Alia5/PiCCANTE/hardware/PiCCANTE-OBD-Dongle/PCB/case/Bottom.stl

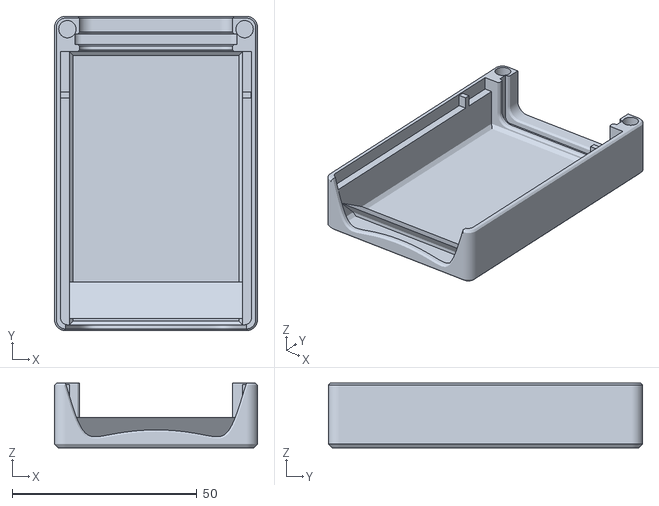
[picture p1: CAD file, 2025-05-24]
hardware/PiCCANTE-OBD-Dongle/PCB/case/Bottom.stl
55.0 x 85.2 x 17.5
