Alia5/PiCCANTE/hardware/PiCCANTE-OBD-Dongle/PCB/case/LID.stl

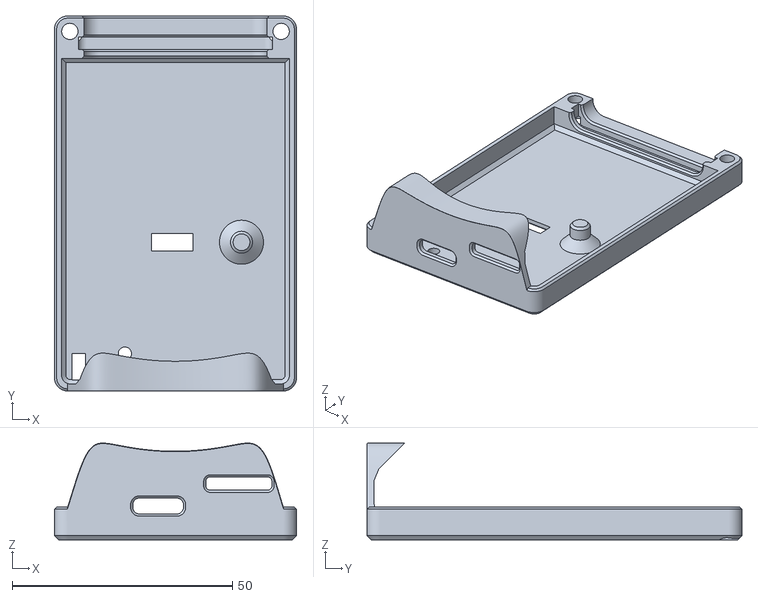
[picture p2: CAD file, 2025-05-24]
hardware/PiCCANTE-OBD-Dongle/PCB/case/LID.stl
55.0 x 85.2 x 22.0
