Alia5/PiCCANTE/hardware/PiCCANTE-OBD-Dongle/Perfboard/case/perfboard/PiCCANTE Case.step

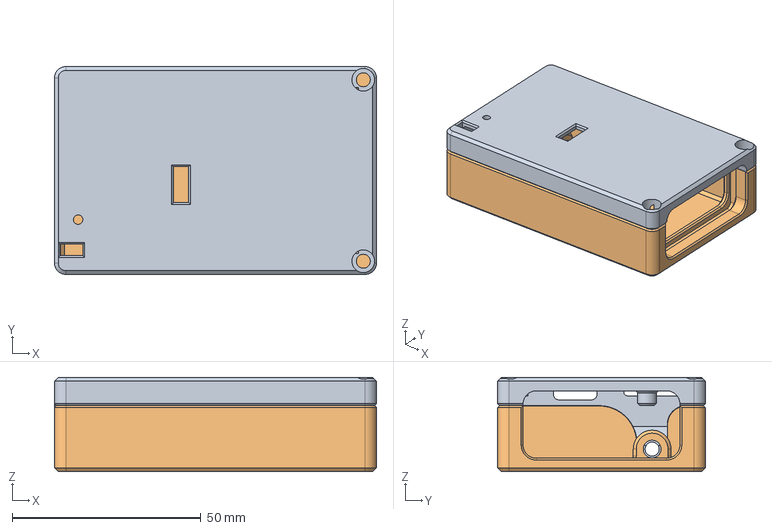
[picture p3: CAD file, 2025-05-03]
hardware/PiCCANTE-OBD-Dongle/Perfboard/case/perfboard/PiCCANTE Case.step
85.2 x 55.0 x 25.0 mm
