Alia5/PiCCANTE/hardware/PiCCANTE-OBD-Dongle/Perfboard/case/perfboard/Lid.stl

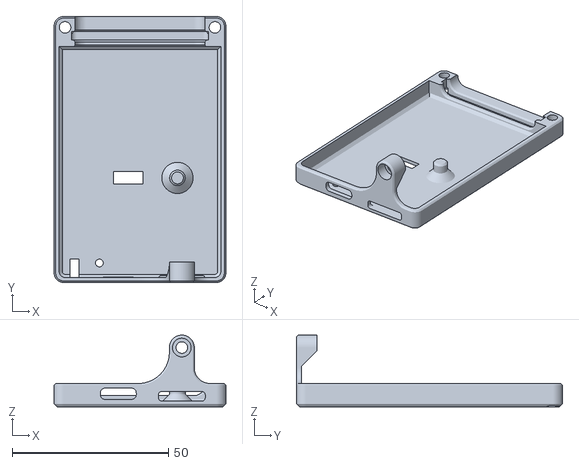
[picture p4: CAD file, 2025-05-03, an earlier design]
hardware/PiCCANTE-OBD-Dongle/Perfboard/case/perfboard/Lid.stl
55.0 x 85.2 x 23.0
