Alia5/PiCCANTE/(list of files, cad)

Other CAD files:
hardware/PiCCANTE-OBD-Dongle/Perfboard/case/perfboard/Bottom.stl
