Alia5/PiCCANTE/(threads)

Thread 2 (2025-04-13):

[FEATURE] Implement ELM327 emulator

Alia5, 2025-04-13:
## Description
Add ELM327 emulator functionality to PiCCANTE to increase compatibility with automotive diagnostic software.

## Requirements
- Support standard ELM327 AT commands
- Implement OBD-II PIDs for common vehicle data
- Allow passthrough to raw CAN commands
- Maintain compatibility with popular OBD-II apps

Alia5, 2025-05-01:
- Supports most basic ELM AT commands (except setting up CAN-bus / protocol scan, memory, filters)
- Compatible with Torque
  - Tested in (2021) Alfa Giulia

Thread 3 (2025-04-13):

[FEATURE] Add WiFi/Bluetooth support for Pico W models

Alia5, 2025-04-13:
## Description
Implement wireless connectivity for Pico W and Pico 2 W models to enable remote vehicle diagnostics and data streaming.

## Requirements
- WiFi Access Point mode for direct connections
- WiFi Client mode for connecting to existing networks
- Bluetooth connectivity for mobile devices
- Secure communication protocols

## Technical Considerations
- Security considerations
  - disable by default
  - requires USB connection to setup
  - no default credentials

Closed 2025-04-14.

Thread 4 (2025-04-13):

[FEATURE] Develop MITM mode for advanced analysis/vehicle tuning

Alia5, 2025-04-13:
## Description
Create a Man-In-The-Middle mode that allows intercepting, modifying, and retransmitting CAN messages for advanced vehicle analysis and tuning.

## Requirements
- Ability to intercept CAN messages between vehicle systems
- Rule-based filtering and modification of messages
- Message logging capabilities
- Optional transparent passthrough mode

## Technical Considerations
- Requires careful timing to avoid vehicle communication issues
- May need buffer management for high-throughput situations

Thread 5 (2025-04-13):

[FEATURE] Implement data logging to SD card

Alia5, 2025-04-13:
Add support for logging CAN bus data directly to SD card for offline analysis and long-term monitoring.

## Requirements
- SD card interface implementation
- Configurable logging formats (CSV, native binary, etc.)
- Timestamping of messages
- Filtering options to reduce storage requirements
- Integration with existing PiCCANTE commands

## Technical Considerations
- SD card interface connections and pin usage
- File system compatibility and reliability
- Performance optimization for continuous logging

Thread 6 (2025-04-13):

[FEATURE] Design 3D printable case for OBD-II dongles

Alia5, 2025-04-13:
## Description
Create 3D printable case designs for making PiCCANTE-based OBD-II dongles that can be easily manufactured by users.

## Requirements
- Compact enclosure for Pico + CAN transceivers
- OBD-II connector integration
- Access to USB port for firmware updates
- Multiple designs for different use cases (basic/advanced)

## Technical Considerations
- Design should be printable on consumer 3D printers
- Include mounting options for optional components (buck converter)

Closed 2025-05-03.

Thread 7 (2025-04-13):

[FEATURE] Design custom PCB for PiCCANTE

Alia5, 2025-04-13:
## Description
Design a custom PCB for PiCCANTE to replace perfboard solutions and simplify assembly.

## Requirements
- Mounting for Raspberry Pi Pico (any model)
- Dedicated interfaces for up to 3 CAN transceivers
- Power management circuitry for automotive use
- Optional OBD-II connector footprint
- Expansion headers for additional functionality

## Technical Considerations
- Should be manufacturable through standard PCB services
- Consider KiCad or similar open-source design software
- Include protection circuitry for automotive environments
- Design for both through-hole and SMD assembly options

Thread 10 (2025-04-14):

[FEATURE]  Web based configuration interface

Alia5, 2025-04-14:
Create a lightweight web interface to configure PiCCANTE through browsers.

### Requirements
- Device Configuration without CLI
- ~Optional CLI~
- Mobile-friendly interface
- ~Visual monitoring of CAN traffic~

### Implementation
- Simple HTTP server on Pico W
- Minimal Svelte SPA
- Store in LittleFS

GitFun4All, 2025-09-17:
This looks really nice (from local npx) but I can't get wifi to come up on a pico2_w.  The bin compiles but setting either a wifi ap mode (results in no ip) or sta advertised or when I try connect mode, it fails to join forever (wpa2 network)?

Closed 2025-04-22.

Thread 9 (2025-04-14):

[FEATURE] Bluetooth on Pico W / Pico 2 W models

Alia5, 2025-04-14:
## Description
Implement bluetooth connectivity for Pico W and Pico 2 W models to enable remote vehicle diagnostics and data streaming.

## Requirements
- Bluetooth connectivity for mobile devices

## Technical Considerations
- Security considerations
  - disable by default
  - requires USB connection to setup
  - no default credentials

Alia5, 2025-05-01:
Currently only implemented for ELM-Emulator

Closed 2025-05-01.

Thread 11 (2025-04-15):

[FEATURE]  Deep Sleep (dormant mode)

Alia5, 2025-04-15:
# Description

Enable deep-sleep mode after a period of CAN inactivity to save power.

# Requirements

- Configurable
- Default on
  - Sane default timeout (5 minutes or so)
- Should auto wake up upon receiving a CAN frame
   - Okay to fully reset the chip on a first draft after wakeup
   - Okay to loose CAN-frames after wakup until reset. (first draft)

Closed 2025-04-15.

Thread 12 (2025-04-15):

Properly handle unread USB-CDC ports

Alia5, 2025-04-15:
# Description.

Currently, there is an arguably "dirty" hack in place to prevent unread CDC-Ports from clogging the tasks.
See: https://github.com/Alia5/PiCCANTE/blob/main/src/outstream/usb_cdc_stream.cpp#L27-L45

A way to properly handle this case should be implemented

Closed 2025-05-01.

Thread 15 (2025-04-29):

[FEATURE]  Watchdog in case Firmware Crashes

Alia5, 2025-04-29:
Enable the Watchdog in case the firmware crashes.

Closed 2025-05-01.

Thread 17 (2025-05-01):

[FEATURE]  ELM327: Extend AT command support to add filters

Alia5, 2025-05-01:
Currently, the ELM327 Emulator doesn't have support for Filters. (`ATCRA`-command)

A fully compatible `ATCRA`-Filter command implementation should be added

Thread 21 (2025-05-02):

[FEATURE]  SD-Card support

Alia5, 2025-05-02:
Implement/add a basic SD-Card / FAT-FS driver

Alia5, 2025-05-02:
Added SD-Card lib from [here ](https://github.com/carlk3/FreeRTOS-FAT-CLI-for-RPi-Pico/tree/master) and added a very basic wrapper in `sd_card/*`

Should be enough to implement data-logging at a later date

Closed 2025-05-02.
