Alia5/PiCCANTE/hardware/PiCCANTE-OBD-Dongle/PCB/PiCCANTE-OBD-Dongle.kicad_pcb

## KiCad design hardware/PiCCANTE-OBD-Dongle/PCB/PiCCANTE-OBD-Dongle.kicad_pcb (2025-05-10)

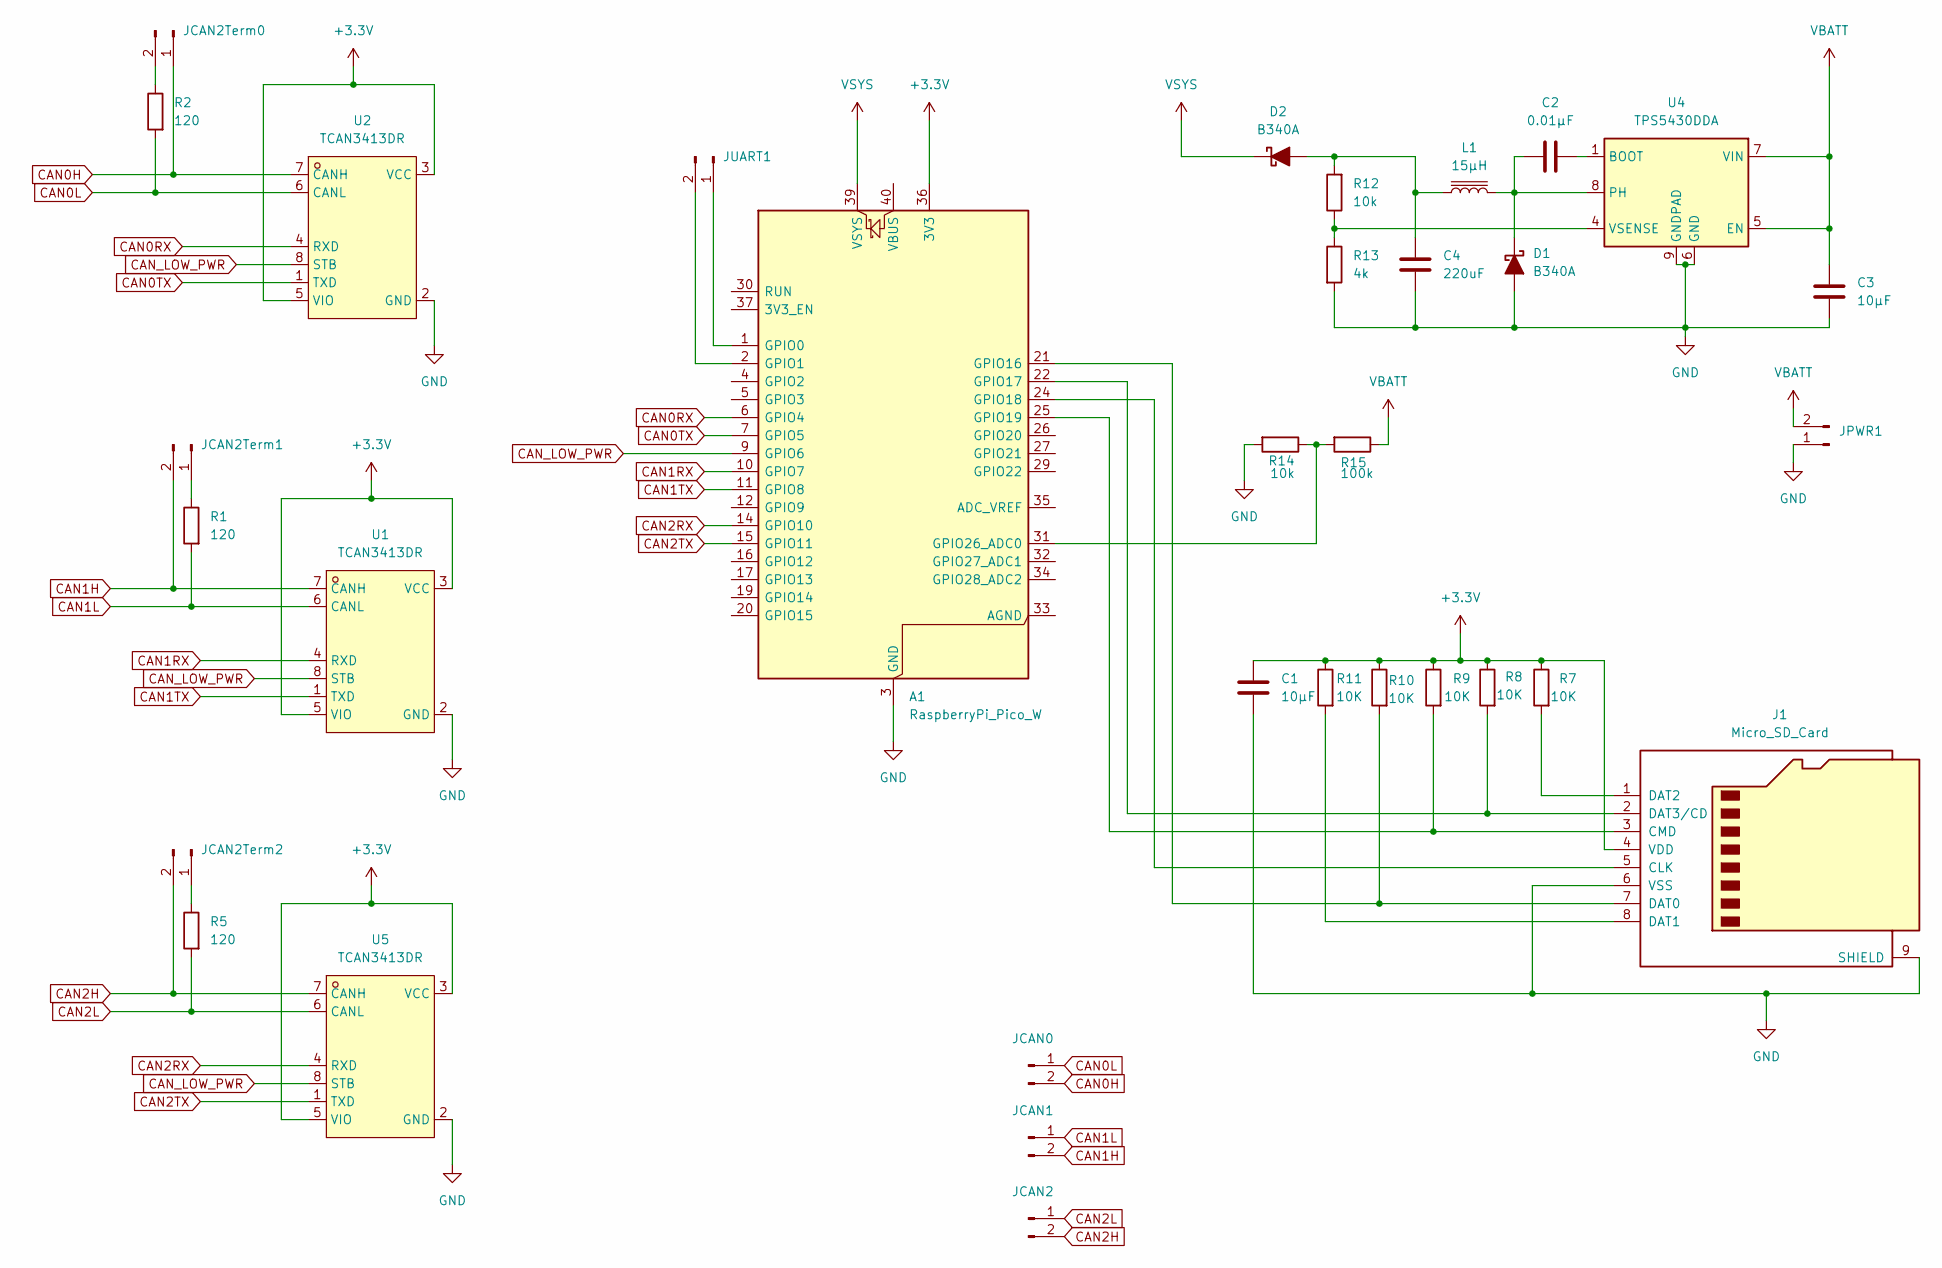
[picture p5: schematic PiCCANTE-OBD-Dongle.kicad_sch]

Parts:
A1: RaspberryPi_Pico_W; RaspberryPi_Pico_W_SMD_THT_COMBO_CUSTOM_KEEPOUT
C1: 10µF; C_0603_1608Metric
C2: 0.01µF; C_0603_1608Metric
C3: 10µF; C_1206_3216Metric
C4: 220uF; C_1206_3216Metric
D1, D2: B340A; SMA_L4.4-W2.6-LS5.0-RD
J1: Micro_SD_Card; TF-SMD_503398-1892
JCAN0, JCAN1, JCAN2, JCAN2Term0, JCAN2Term1, JCAN2Term2: PinHeader_1x02_P2.54mm_Vertical
JPWR1: PinHeader_1x02_P2.54mm_Horizontal
JUART1: PinHeader_1x02_P2.54mm_Vertical
L1: 15µH; IND-SMD_L4.0-W4.0
R1, R2, R5: 120; R_0603_1608Metric
R7, R8, R9, R10, R11: 10K; R_0603_1608Metric
R12, R14: 10k; R_0603_1608Metric
R13: 4k; R_0603_1608Metric
R15: 100k; R_0603_1608Metric
U1, U2, U5: TCAN3413DR; SOP-8_L4.9-W3.9-P1.27-LS6.0-BL-1; LCSC Part C22433320
U4: TPS5430DDA; TI_SO-PowerPAD-8_ThermalVias

Connections:
+3.3V: A1.36 (3V3), C1.1, J1.4 (VDD), R7.1, R8.1, R9.1, R10.1, R11.1, U1.3 (VCC), U1.5 (VIO), U2.3 (VCC), U2.5 (VIO), U5.3 (VCC), U5.5 (VIO)
CAN0H: JCAN0.2, JCAN2Term0.1, U2.7 (CANH)
CAN0L: JCAN0.1, R2.1, U2.6 (CANL)
CAN0RX: A1.6 (GPIO4), U2.4 (RXD)
CAN0TX: A1.7 (GPIO5), U2.1 (TXD)
CAN1H: JCAN1.2, JCAN2Term1.2, U1.7 (CANH)
CAN1L: JCAN1.1, R1.1, U1.6 (CANL)
CAN1RX: A1.10 (GPIO7), U1.4 (RXD)
CAN1TX: A1.11 (GPIO8), U1.1 (TXD)
CAN2H: JCAN2.2, JCAN2Term2.2, U5.7 (CANH)
CAN2L: JCAN2.1, R5.1, U5.6 (CANL)
CAN2RX: A1.14 (GPIO10), U5.4 (RXD)
CAN2TX: A1.15 (GPIO11), U5.1 (TXD)
CAN_LOW_PWR: A1.9 (GPIO6), U1.8 (STB), U2.8 (STB), U5.8 (STB)
GND: A1.3 (GND), A1.8 (GND), A1.13 (GND), A1.18 (GND), A1.23 (GND), A1.28 (GND), A1.38 (GND), C1.2, C3.2, C4.2, D1.2 (A), J1.6 (VSS), J1.9 (SHIELD), JPWR1.1, R13.2, R14.2, U1.2 (GND), U2.2 (GND), U4.6 (GND), U4.9 (GNDPAD), U5.2 (GND)
unnamed: A1.1 (GPIO0), JUART1.1
unnamed: A1.2 (GPIO1), JUART1.2
unnamed: A1.21 (GPIO16), J1.7 (DAT0), R10.2
unnamed: A1.22 (GPIO17), J1.2 (DAT3/CD), R8.2
unnamed: A1.24 (GPIO18), J1.5 (CLK)
unnamed: A1.25 (GPIO19), J1.3 (CMD), R9.2
unnamed: A1.31 (GPIO26_ADC0), R14.1, R15.2
unnamed: C2.2, D1.1 (K), L1.2, U4.8 (PH)
unnamed: C4.1, D2.2 (A), L1.1, R12.2
unnamed: J1.8 (DAT1), R11.2
unnamed: J1.1 (DAT2), R7.2
unnamed: JCAN2Term0.2, R2.2
unnamed: JCAN2Term1.1, R1.2
unnamed: JCAN2Term2.1, R5.2
unnamed: C2.1, U4.1 (BOOT)
unnamed: R12.1, R13.1, U4.4 (VSENSE)
VBATT: C3.1, JPWR1.2, R15.1, U4.5 (EN), U4.7 (VIN)
VSYS: A1.39 (VSYS), D2.1 (K)

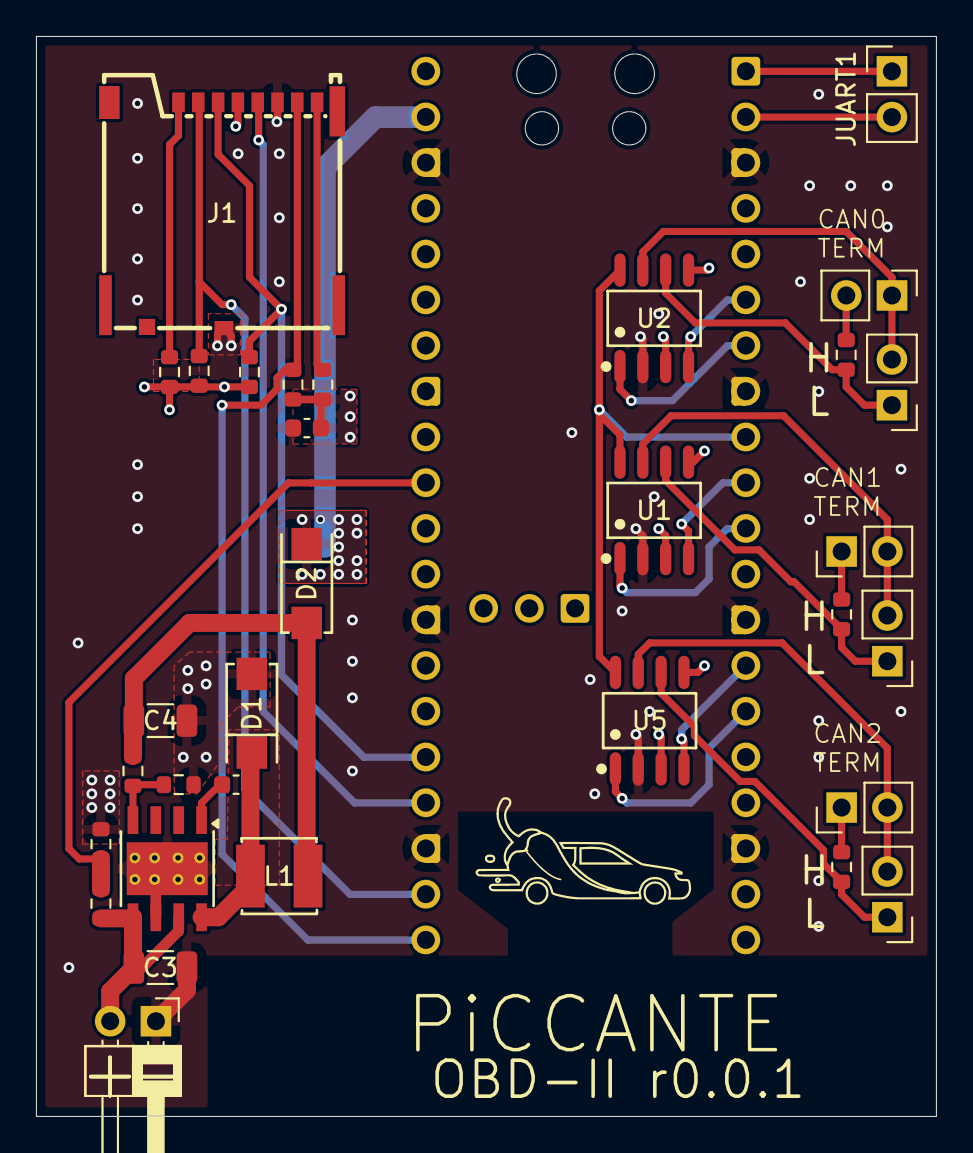
[picture p6: board PiCCANTE-OBD-Dongle.kicad_pcb from above]

Board: 4 copper layers, 50.0 x 60.0 mm, 33 parts (1 on the bottom side), 33 nets.
