Alia5/PiCCANTE/src/power/sleep.cpp

/*
 * PiCCANTE - PiCCANTE Car Controller Area Network Tool for Exploration
 * Copyright (C) 2025 Peter Repukat
 *
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
 * You should have received a copy of the GNU General Public License
 * along with this program.  If not, see <https://www.gnu.org/licenses/>.
 */
#include "sleep.hpp"
#include "led/led.hpp"
#include "Logger/Logger.hpp"
#include "hardware/structs/scb.h"
#include "hardware/gpio.h"
#include "hardware/timer.h"
#include "FreeRTOS.h"
#include "timers.h"
#include "task.h"
#include <hardware/watchdog.h>
#include <pico/multicore.h>
#include <pico/sleep.h>

#include "SysShell/settings.hpp"
#ifdef WIFI_ENABLED
#include "wifi/wifi.hpp"
#include <pico/cyw43_arch.h>
#include <cyw43.h>
#include <cyw43_ll.h>
#endif

namespace piccante::power::sleep {

namespace {
bool sleeping = false;
TimerHandle_t idle_timer = nullptr;
TaskHandle_t idle_task_handle = nullptr;

bool timer_should_reset = false;

void idle_timer_callback(TimerHandle_t timer) {
    if (!sleeping) {
        Log::info << "CAN idle timeout reached, entering sleep mode\n";
        xTimerStop(timer, 0);
        xTimerDelete(timer, 0);
        idle_timer = nullptr;

        enter_sleep_mode();
    }
}

void idle_detection_task(void* params) {
    (void)params;


    vTaskDelay(pdMS_TO_TICKS(1000)); // Time for other tasks
    Log::info << "Idle detection task started\n";

    gpio_init(6);
    gpio_set_dir(6, true);
    gpio_put(6, false);

    uint8_t idle_minutes_prev = 0;

    for (;;) {
        const auto idle_minutes = sys::settings::get_idle_sleep_minutes();
        if (idle_minutes > 0 && !sleeping) {
            if (idle_timer == nullptr) {
                idle_timer = xTimerCreate("IdleTimer",
                                          pdMS_TO_TICKS(idle_minutes * 60 * 1000),
                                          pdFALSE, // One-shot timer
                                          nullptr,
                                          idle_timer_callback);

                if (idle_timer == nullptr) {
                    Log::error << "Failed to create idle timer\n";
                    vTaskDelay(pdMS_TO_TICKS(1000));
                    continue;
                }

                if (xTimerStart(idle_timer, 0) != pdPASS) {
                    Log::error << "Failed to start idle timer\n";
                }

                Log::info << "Idle timer started: " << std::to_string(idle_minutes)
                          << " minutes\n";
                idle_minutes_prev = idle_minutes;

            } else if (idle_minutes_prev != idle_minutes) {
                Log::info << "Idle timeout changed: " << std::to_string(idle_minutes_prev)
                          << " -> " << std::to_string(idle_minutes) << " minutes\n";
                idle_minutes_prev = idle_minutes;
                xTimerStop(idle_timer, 0);
                xTimerChangePeriod(
                    idle_timer, pdMS_TO_TICKS(idle_minutes * 60 * 1000), 0);
                if (xTimerStart(idle_timer, 0) != pdPASS) {
                    Log::error << "Failed to restart idle timer\n";
                }
            }
        } else if (idle_timer != nullptr && (idle_minutes == 0 || sleeping)) {
            xTimerStop(idle_timer, 0);
            xTimerDelete(idle_timer, 0);
            idle_timer = nullptr;

            if (idle_minutes == 0) {
                Log::info << "Idle timeout disabled\n";
            }
        }
        if (timer_should_reset) {
            xTimerReset(idle_timer, 0);
            timer_should_reset = false;
        }
        watchdog_update();
        vTaskDelay(pdTICKS_TO_MS(1000));
    }
}
} // namespace

void init() {
    const auto result = xTaskCreate(idle_detection_task,
                                    "IdleDetect",
                                    configMINIMAL_STACK_SIZE / 2,
                                    nullptr,
                                    tskIDLE_PRIORITY + 1,
                                    &idle_task_handle);

    if (result != pdPASS) {
        Log::error << "Failed to create idle detection task\n";
        return;
    }

    watchdog_enable(10000, true);
    Log::info << "Watchdog enabled with 10s timeout\n";
}

void reset_idle_timer() {
    timer_should_reset = true;
    if (sleeping) {
        wake_up();
    }
}


void enter_sleep_mode() {
    if (sleeping) {
        return;
    }

    sleeping = true;

    Log::info << "Going to sleep\n";
    watchdog_disable();
    led::set_mode(led::MODE_OFF);

    gpio_put(6, true);

#ifdef WIFI_ENABLED
    wifi::stop();
    vTaskDelay(pdMS_TO_TICKS(100));
    cyw43_arch_deinit();
#endif


    // Allow log to flush / other core to sleep.
    vTaskDelay(pdMS_TO_TICKS(100));
    vTaskSuspendAll();


    multicore_reset_core1();

    sleep_run_from_rosc();
    sleep_goto_dormant_until_edge_high(piccanteCAN0_RX_PIN);

    // If we get here, the device has woken up
    wake_up();
}

void wake_up() {
    if (!sleeping) {
        return;
    }

    sleeping = false;
    Log::info << "Waking up from deep sleep\n";

    watchdog_reboot(0, SRAM_END, 10);

    // Instead of restoring all functionality,
    // it's way easier to just reset the board entirely.
    // So for a first implementation, this is what we'll do
    // We loose a few CAN-Frames but for an initial implementation this is fine.
    // TODO: proper wakeup routine. Maybe.
}


} // namespace piccante::power::sleep
