Alia5/PiCCANTE/src/SysShell/handler.hpp

/*
 * PiCCANTE - PiCCANTE Car Controller Area Network Tool for Exploration
 * Copyright (C) 2025 Peter Repukat
 *
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
 * You should have received a copy of the GNU General Public License
 * along with this program.  If not, see <https://www.gnu.org/licenses/>.
 */
#pragma once
#include <vector>
#include <string_view>
#include <map>
#include <functional>
#include "outstream/stream.hpp"
#include "settings.hpp"
#include "CommProto/gvret/handler.hpp"

namespace piccante::sys::shell {


class handler {
        public:
    explicit handler(gvret::handler& gvret, out::stream& out_stream,
                     const settings::system_settings& cfg = settings::get())
        : gvret(gvret), host_out(out_stream), cfg(cfg) {};
    ~handler() = default;

    // Disable copy and move operations
    handler(const handler&) = delete;
    handler& operator=(const handler&) = delete;
    handler(handler&&) = delete;
    handler& operator=(handler&&) = delete;

    void process_byte(char byte);
    void handle_cmd(const std::string_view& cmd);

    bool check_and_reset_cancel();

        private:
    gvret::handler& gvret;
    out::stream& host_out;
    std::vector<char> buffer{};
    const settings::system_settings& cfg;

    bool cancel_requested = false;

    struct CommandInfo {
        std::string_view description;
        void (handler::*func)(const std::string_view&);
        void operator()(handler* self, const std::string_view& arg) const {
            (self->*func)(arg);
        }
    };
    static std::map<std::string_view, CommandInfo, std::less<>> commands;

    // Command handlers
    void cmd_echo(const std::string_view& arg);
    void cmd_help(const std::string_view& arg);
    void cmd_toggle_binary(const std::string_view& arg);
    void cmd_can_enable(const std::string_view& arg);
    void cmd_can_disable(const std::string_view& arg);
    void cmd_can_bitrate(const std::string_view& arg);
    void cmd_can_status(const std::string_view& arg);
    void cmd_can_num_busses(const std::string_view& arg);
    void cmd_settings_show(const std::string_view& arg);
    void cmd_settings_store(const std::string_view& arg);
    void cmd_led_mode(const std::string_view& arg);
    void cmd_log_level(const std::string_view& arg);
    void cmd_sys_stats(const std::string_view& arg);
    void cmd_reset(const std::string_view& arg);
    void cmd_sleep(const std::string_view& arg);
    void cmd_idle_timeout(const std::string_view& arg);
    void cmd_version(const std::string_view& arg);
    void cmd_can_baud_lockout(const std::string_view& arg);
    void cmd_can_bridge(const std::string_view& arg);

    void cmd_elm(const std::string_view& arg);

    void cmd_elm_atz(const std::string_view& arg);

#ifdef WIFI_ENABLED
    void cmd_wifi(const std::string_view& arg);
    void cmd_telnet(const std::string_view& arg);
#endif
};
} // namespace piccante::sys::shell
