Alia5/PiCCANTE/(commit log)

2025-03-30 Working CanBus Sample on FreeRTOS
2025-03-30 Add Preliminary CanBus abstraction
2025-03-31 switch to pico 2 w
2025-04-05 Fix stupid broken vscode-native clang-tidy with c++23
    [build_can_frame.hpp, set_systype.hpp, time_sync.hpp]
2025-04-05 Rework CanBus abstraction
2025-04-05 Env configurable pico board/platform
2025-04-05 Add little-fs driver w/ pre built and in-elf little-fs image 🤘
2025-04-06 Remove std::XYZstream and pico/stdio bloat
2025-04-06 Fix littlefs driver
2025-04-06 Fix default canbus nums
2025-04-06 completely disable/remove pico/stdio uart
2025-04-06 persistent canbus settings
2025-04-07 Fix canbus number ifdefs
    [CanBus.cpp]
2025-04-12 Fix stream sending 0 bytes for strings
    [stream.hpp]
2025-04-12 set CAN interrupts on core two
2025-04-12 Fix canbus reset issues
    [CanBus.cpp]
2025-04-12 Generate as many cdc interfaces as slcan devices +1
2025-04-13 Init cyw43 on supported boards / add LED toggle
2025-04-13 CI: Build variants for non "w" boards
2025-04-13 Add led mode command
2025-04-13 Fix LED init when on non W board
    [main.cpp]
2025-04-14 Add ADC to stats
2025-04-14 Add GitHub Sponsors buttons
2025-04-14 Change default telnet port since SavvyCAN required it on 23 🙄
2025-04-14 Fix GVRET interfering with piccante_cmd handler
    [get_command.hpp]
2025-04-15 Pull in pico-extras
2025-04-15 Add missing settings to settings cmd
    [handler.cpp]
2025-04-16 Fix Idle Timer
2025-04-16 Fix GVRET CAN frame/keepalive interleave
    [handler.cpp]
2025-04-18 W Boards: Add httpd
2025-04-19 Bundle web-assets automagically on w boards
2025-04-20 Fix setting led_mode
2025-04-20 Add settings-save (and reset) endpoint
    [settings.cpp, settings.hpp]
2025-04-20 Fix sending null term byte in json
    [settings.cpp]
2025-04-20 Fix fmt adding 0 term to std::stirngs
    [fmt.hpp, stream.hpp]
2025-04-20 Fix wake_up from idle timer
    [sleep.cpp]
2025-04-20 /api/settings: set can props from api
2025-04-20 Add missing listen_only to (can) /api/settings
    [settings.cpp]
2025-04-22 Fix stats API malformed json
    [stats.cpp]
2025-04-22 Add CanBus Stats
2025-04-23 Fix init/wake_up if there are comms on the bus
    [CanBus.cpp]
2025-04-24 Fix changing Idle timeout
    [sleep.cpp]
2025-04-24 Hopefully fix possible crash upon going to sleep
    [sleep.cpp]
2025-04-24 Greatly increase CAN RX Task performance
    - Setting led state can take a long time on W board (spi via cyw43 chip)
    Replaced with simple bool flag and separate blink task
    - Resetting timers can cause significant delay
    Replaced with simple bool flag checked in idle-detect task
    [CanBus.cpp, led.cpp, led.hpp, main.cpp, sleep.cpp]
2025-04-24 Decrease LED Blink-TaskStacksize
2025-04-25 Adjust Canbus delay logic
2025-04-25 Elm327: support/handle "expected number of frames" in pid requests
2025-04-26 Try to fix some random btstack crash
    [btstack_config.h, main.cpp]
2025-04-27 WIP: ELM: Multi Frame messages
2025-04-27 ELM327: Add flow control
2025-04-27 Safely read VSYS Adc on PicoW
2025-04-28 support longer pid requests
2025-04-28 ELM: Fix multi frame responses / remove adaptive timeout for now
2025-04-28 Fix Slow canbus send
    [CanBus.cpp, CanBus.hpp, main.cpp]
2025-04-28 ELM: Fix multi-frame pids
2025-04-28 ELM: automagically set usage of extended frame when setting extended header
2025-05-01 (Re-)Disable printf to uart
2025-05-01 Add watchdog to recover from FW-crashes
    [sleep.cpp]
2025-05-02 Fix crash on high can activity
    [CanBus.cpp, CanBus.hpp, led.cpp, main.cpp, sleep.cpp]
2025-05-02 Fix watchdog interferring with debugger
    [sleep.cpp]
2025-05-02 Clear up some performance issues
    [CanBus.cpp, main.cpp]
2025-05-03 Add HW Schematic / Images
2025-05-03 Perfobaord image: Fix missing Pico
2025-05-03 Add 3D printed case
    [Bottom.stl, Lid.stl, PiCCANTE Case.step]
2025-05-03 Add theoretical support to power / up/down can transceivers
2025-05-03 Update default pin values
2025-05-03 Adjust ADC0 Voltage multiplier
2025-05-03 Fix canbus-settings over api
    [settings.cpp]
2025-05-03 ELM-Emu: Report voltage via ADC
2025-05-10 Add custom pcb design
    [PiCCANTE-OBD-Dongle.kicad_pcb, PiCCANTE-OBD-Dongle.kicad_sch]
2025-05-10 Switch out TRX / "Improve" Routing
    [PiCCANTE-OBD-Dongle.kicad_pcb, PiCCANTE-OBD-Dongle.kicad_sch]
2025-05-10 Put pico on the other side
    [PiCCANTE-OBD-Dongle.kicad_pcb, PiCCANTE-OBD-Dongle.kicad_sch]
2025-05-10 Fix missing pragma pack on wifi settings
    [settings.hpp]
2025-05-10 Add can speed lock setting
    Prevents GVRET / SLCAN interfaces from changing CAN bus speed
    Changelog: feature
    [handler.cpp, handler.hpp, set_canbus_params_3_4_5.hpp, settings.cpp, settings.hpp, setup_canbus_1_2.hpp]
2025-05-24 Fix littlefs driver SMP
2025-05-24 Add Case for manufactured PCB
    [Bottom.stl, LID.stl]
2025-05-24 FIXME: Add low power output for ca trx on pcb
    [sleep.cpp]
2025-05-25 Fix GVRET only exposing CAN0
    Changelog: fix
    [get_num_buses.hpp]
2025-05-25 Use single callback for all can buses
2025-05-25 Fix can pin assignments
2025-05-25 Make CAN2 read only on W boards...
2025-05-28 Reserve PIOs for CanBuses - Leaving 2 free if bus is read_only
