Alia5/PiCCANTE/(notices)

Notices in the files:
Readme.md:
License: GPL-3.0
